atomicra1n/mechanical-wall-clock/images/clock-back.png

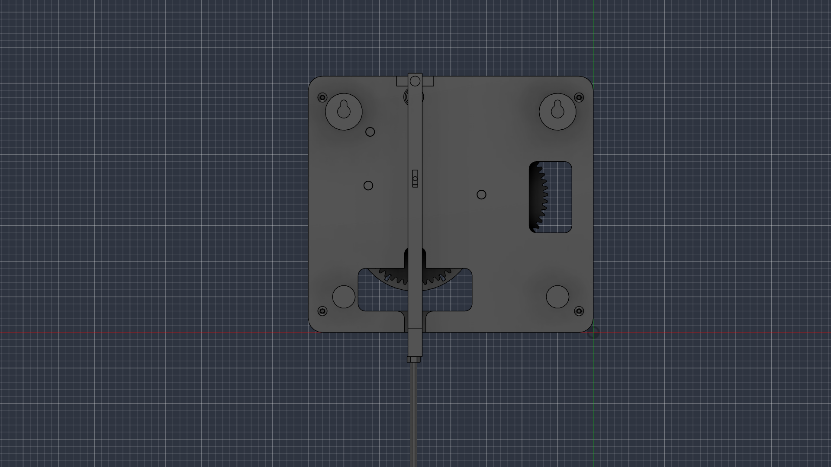
images/clock-back.png
