atomicra1n/mechanical-wall-clock/images/clock-full.png

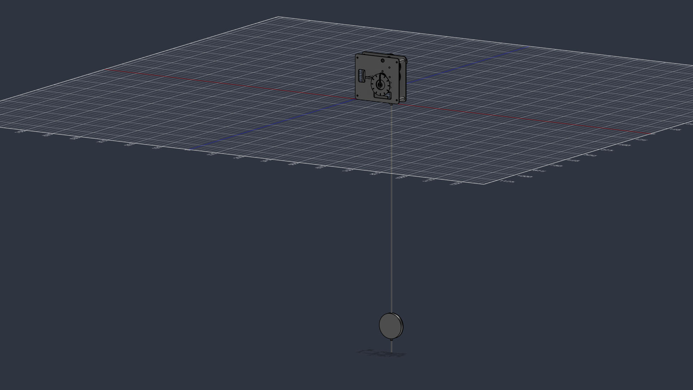
images/clock-full.png
