atomicra1n/mechanical-wall-clock/images/clock-side.png

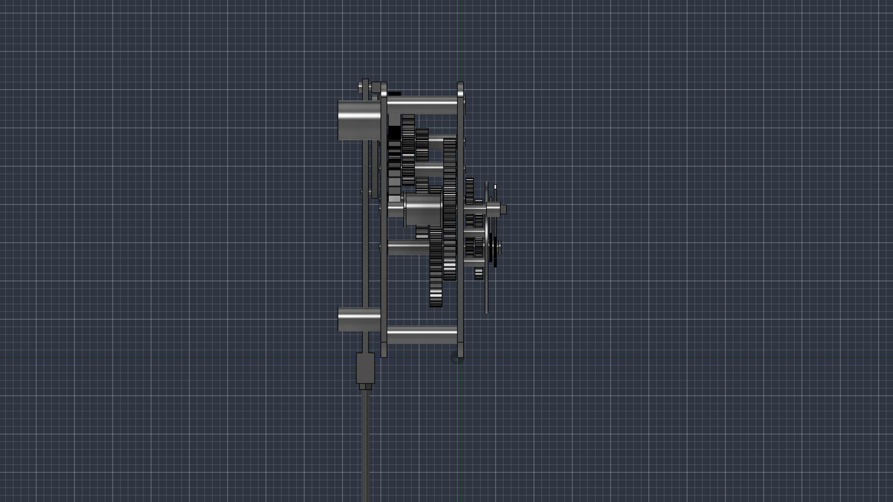
images/clock-side.png
