atomicra1n/mechanical-wall-clock/BOM.csv

Item | Qty | Supplier | Cost/item | Total Cost | link
Alu round rod 6 mm × 1 m | 1 | Hornbach | $2.50 | $2.50 | https://www.hornbach.cz/p/alu-kruhovy-profil-6mm-1m/6369446/
Zn threaded rod M5 1 m | 1 | Hornbach | $0.80 | $0.80 | https://www.hornbach.cz/p/tyc-zavitova-1m-m5-pevnost-4-8-zinek-bily-1ks/4279646/
100 pack of DIN 7985 cross-head M4x12 pan-head screws | 1 | Hornbach | $3.93 | $3.93 | https://www.hornbach.cz/p/sroub-s-cockovitou-hlavou-4-8-a-krizovou-drazkou-din-7985-m4x12-mm-galvanicky-pozinkovany-1-ks/3831265/
20 pack of M5 hex nuts, stainless A2 | 1 | Hornbach | $1.56 | $1.56 | https://www.hornbach.cz/p/matice-presna-m5-sestihranna-nerez-a2-20ks/8718281/
Bison Super Glue Gel 2 grams | 1 | Hornbach | $2.08 | $2.08 | https://www.hornbach.cz/p/vterinove-lepidlo-bison-super-glue-gel-2-g/6065686/
Polyester line 1 mm, 50 m | 1 | Hornbach | $3.40 | $3.40 | https://www.hornbach.cz/p/zednicky-provazek-haromac-delka-50m-cerveny/910338/
Elegoo PLA grey, 1.75 mm, 1 kg | 1 | Sunnysoft | $12.00 | $12.00 | https://www.sunnysoft.cz/z/400PEO-060/elegoo-pla-1-75-1kg-seda.html
Estimated total shipping | 1 |  |  | $3.00
