atomicra1n/mechanical-wall-clock/cad/mechanical-wall-clock.step

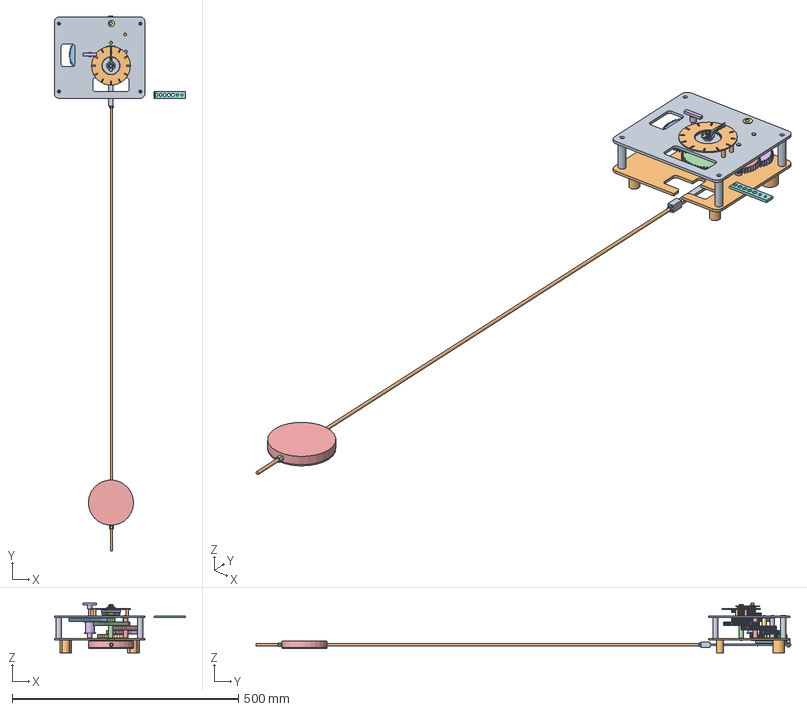
[picture p6: CAD file, 2026-11-11]
cad/mechanical-wall-clock.step
290.0 x 1183.0 x 110.0 mm
