atomicra1n/mechanical-wall-clock/stl/hour-hand.stl

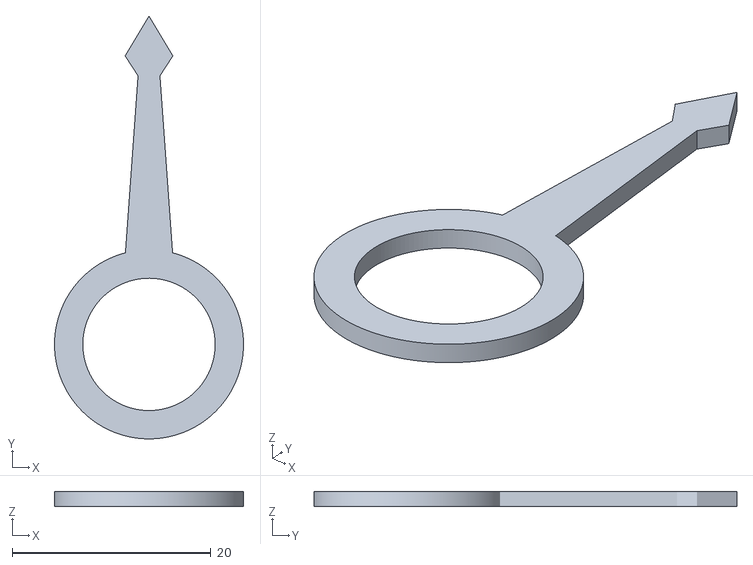
[picture p7: CAD file, 2026-11-11]
stl/hour-hand.stl
19.0 x 42.5 x 1.50
