atomicra1n/mechanical-wall-clock/stl/minute-wheel.stl

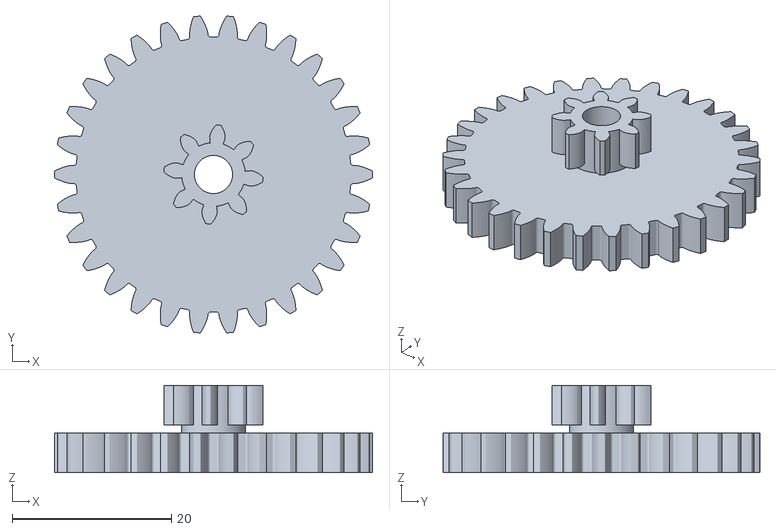
[picture p8: CAD file, 2026-11-11]
stl/minute-wheel.stl
40.0 x 39.9 x 11.0
