atomicra1n/mechanical-wall-clock/stl/hand-collet.stl

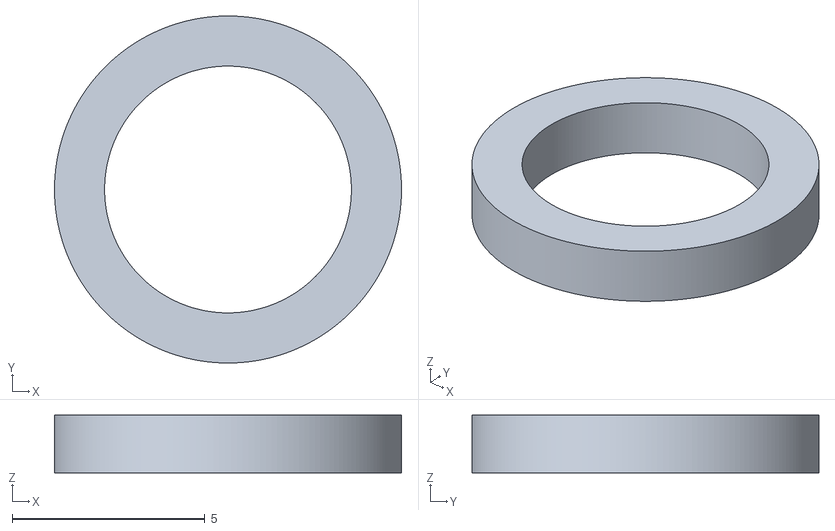
[picture p9: CAD file, 2026-11-11]
stl/hand-collet.stl
9.00 x 9.00 x 1.50
