atomicra1n/mechanical-wall-clock/stl/pendulum-top.stl

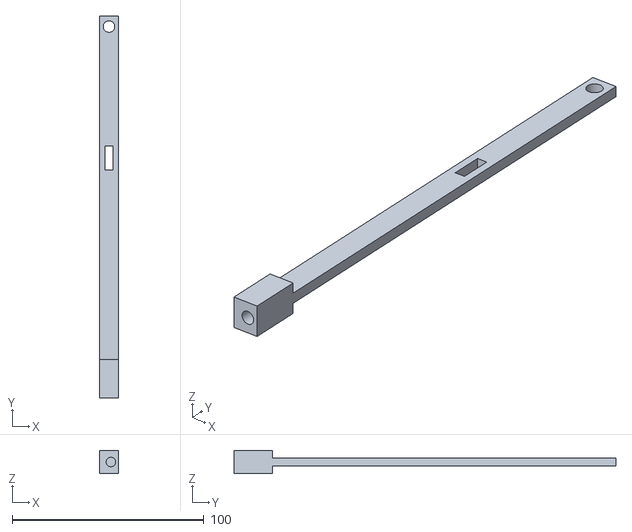
[picture p10: CAD file, 2026-11-11]
stl/pendulum-top.stl
10.0 x 199.0 x 12.0
