atomicra1n/mechanical-wall-clock/stl/hour-wheel.stl

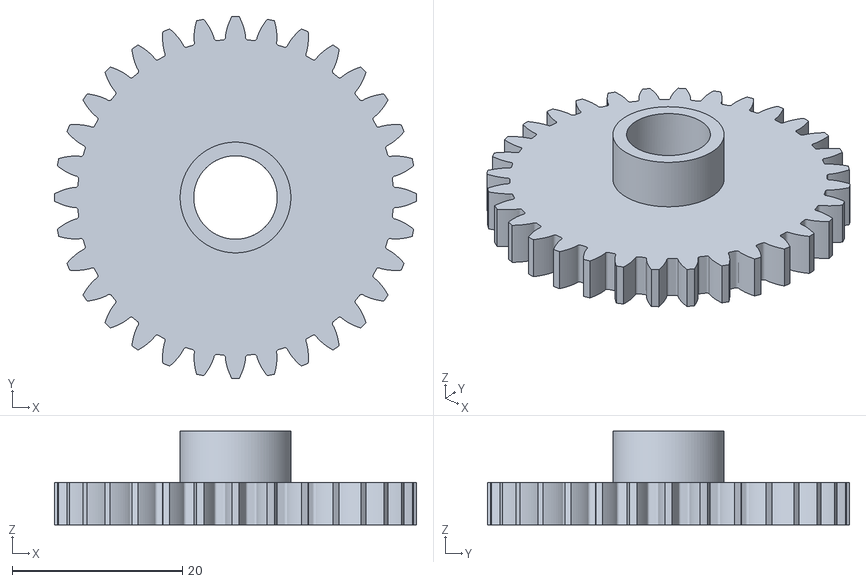
[picture p11: CAD file, 2026-11-11]
stl/hour-wheel.stl
42.5 x 42.5 x 11.0
