atomicra1n/mechanical-wall-clock/stl/dial.stl

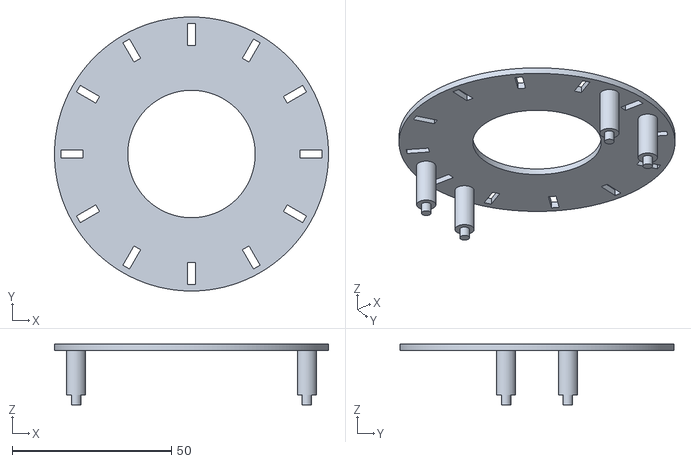
[picture p12: CAD file, 2026-11-11]
stl/dial.stl
86.0 x 86.0 x 19.0
