atomicra1n/mechanical-wall-clock/stl/cannon-pinion.stl

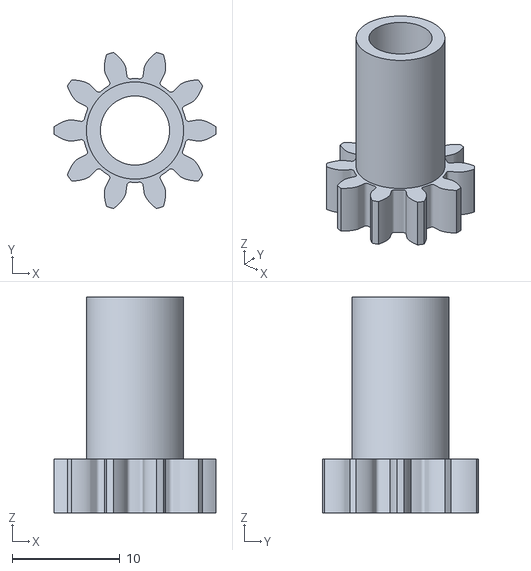
[picture p13: CAD file, 2026-11-11]
stl/cannon-pinion.stl
15.0 x 14.5 x 20.0
