atomicra1n/mechanical-wall-clock/stl/minute-hand.stl

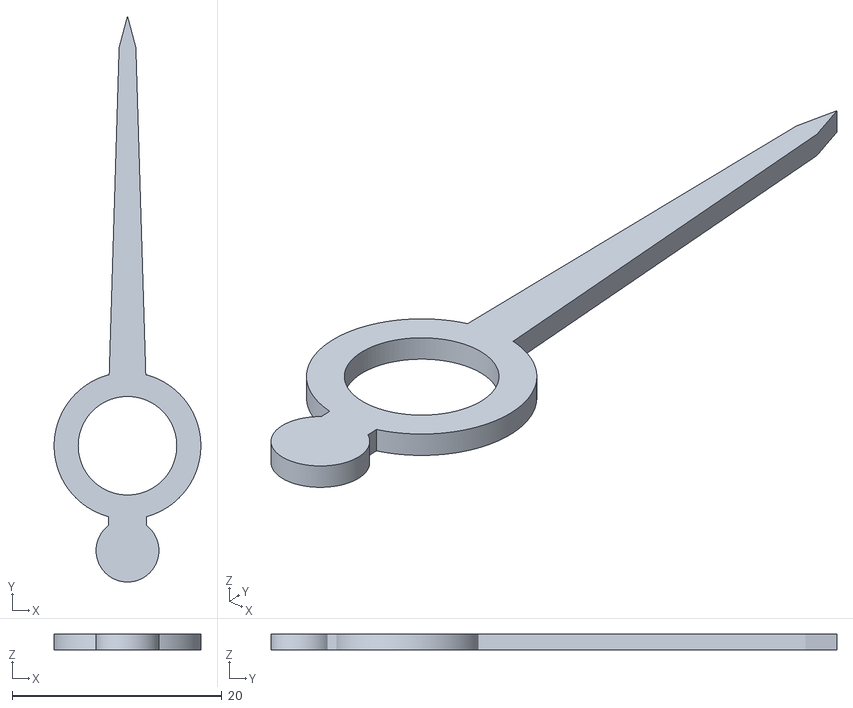
[picture p14: CAD file, 2026-11-11]
stl/minute-hand.stl
14.0 x 54.0 x 1.50
