atomicra1n/mechanical-wall-clock/stl/crutch.stl

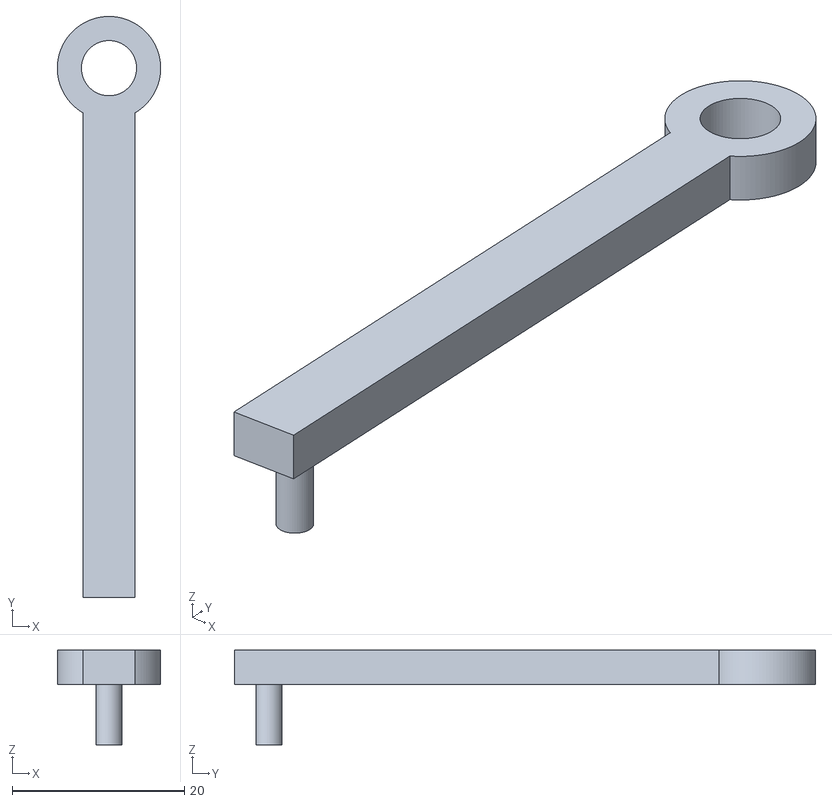
[picture p15: CAD file, 2026-11-11]
stl/crutch.stl
12.0 x 67.4 x 11.0
