atomicra1n/mechanical-wall-clock/stl/winding-drum.stl

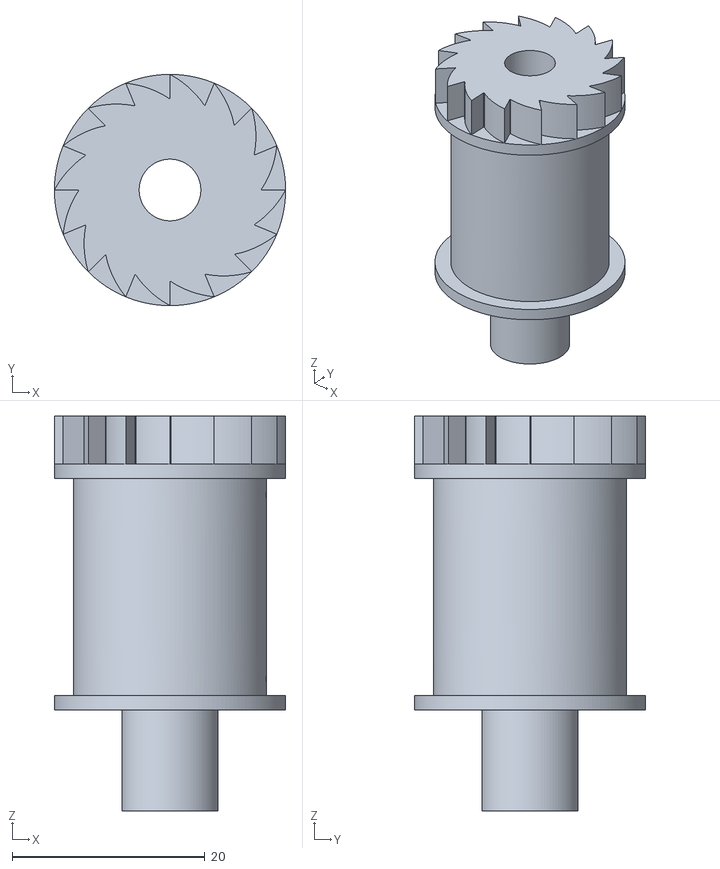
[picture p16: CAD file, 2026-11-10]
stl/winding-drum.stl
24.0 x 24.0 x 41.0
