atomicra1n/mechanical-wall-clock/stl/great-wheel.stl

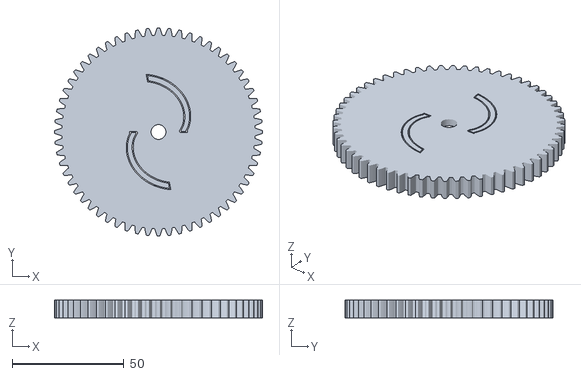
[picture p17: CAD file, 2026-11-10]
stl/great-wheel.stl
93.0 x 93.0 x 8.00
