atomicra1n/mechanical-wall-clock/stl/winding-knob.stl

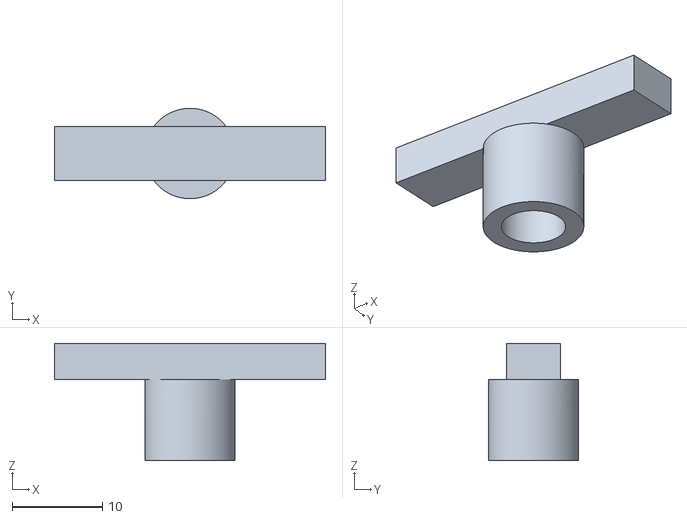
[picture p18: CAD file, 2026-11-10]
stl/winding-knob.stl
30.0 x 10.0 x 13.0
