atomicra1n/mechanical-wall-clock/stl/anchor.stl

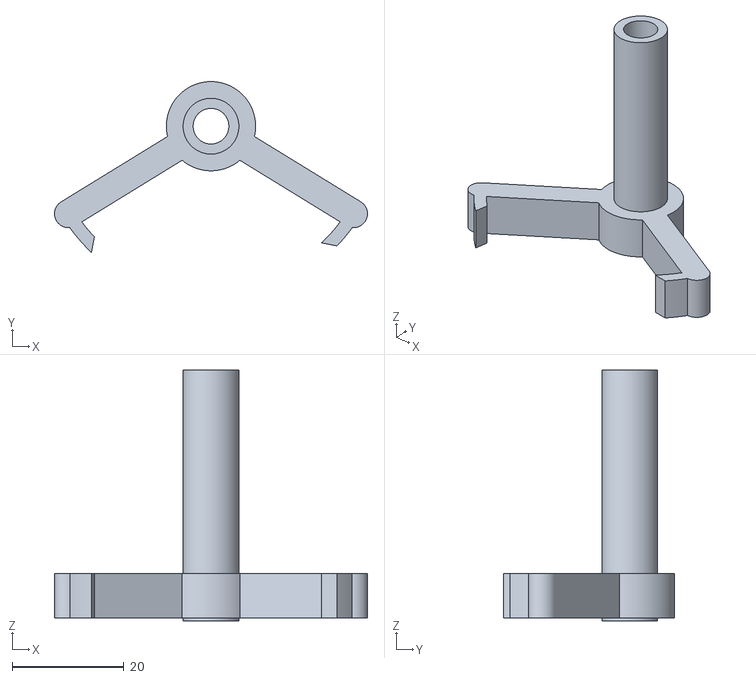
[picture p19: CAD file, 2026-11-09]
stl/anchor.stl
56.1 x 30.6 x 45.0
