atomicra1n/mechanical-wall-clock/stl/third-arbor.stl

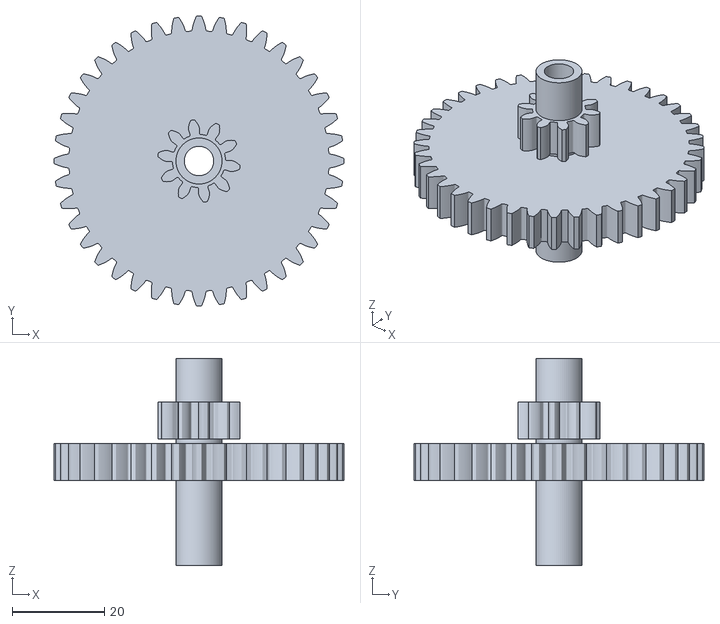
[picture p20: CAD file, 2026-11-09]
stl/third-arbor.stl
63.0 x 63.0 x 45.0
