atomicra1n/mechanical-wall-clock/stl/escape-arbor.stl

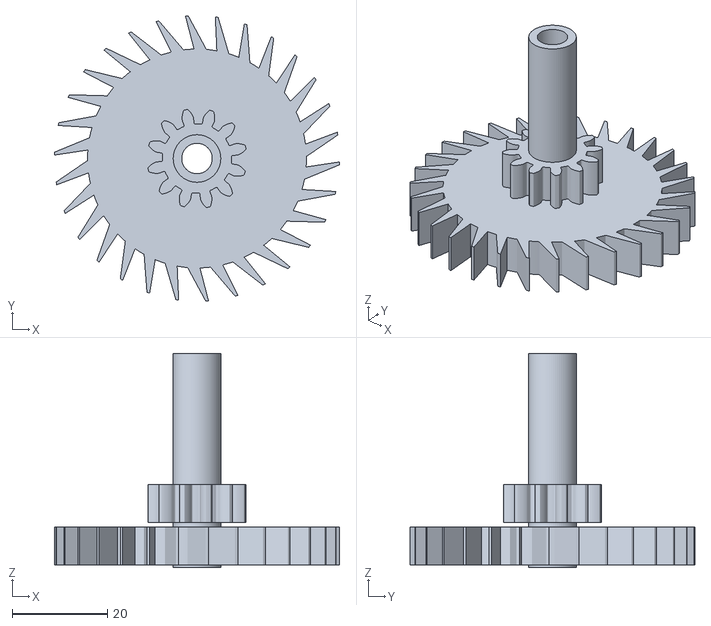
[picture p21: CAD file, 2026-11-09]
stl/escape-arbor.stl
60.0 x 59.9 x 45.0
