atomicra1n/mechanical-wall-clock/stl/center-arbor.stl

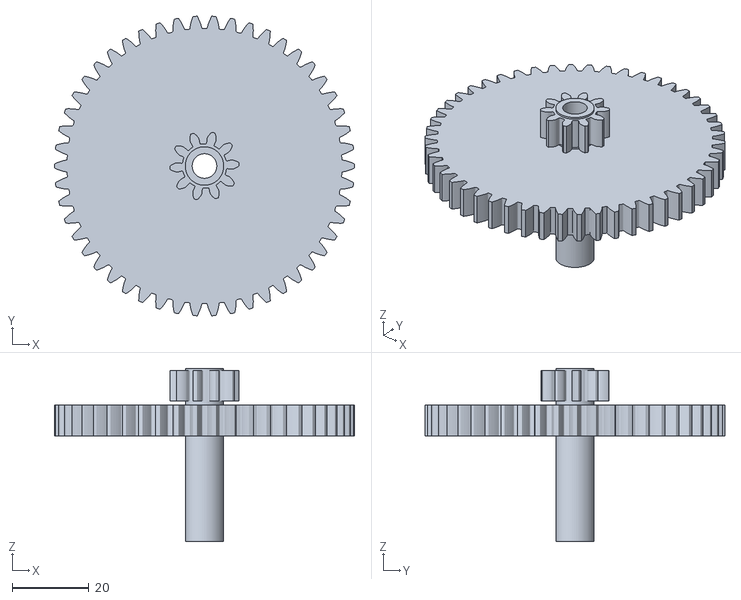
[picture p22: CAD file, 2026-11-09]
stl/center-arbor.stl
78.0 x 77.9 x 45.0
