atomicra1n/mechanical-wall-clock/stl/pendulum-bob.stl

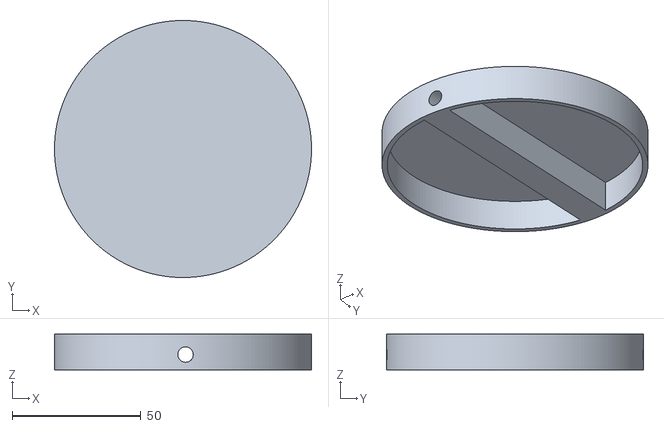
[picture p23: CAD file, 2026-11-08]
stl/pendulum-bob.stl
100.0 x 100.0 x 14.0
