atomicra1n/mechanical-wall-clock/stl/bob-lid.stl

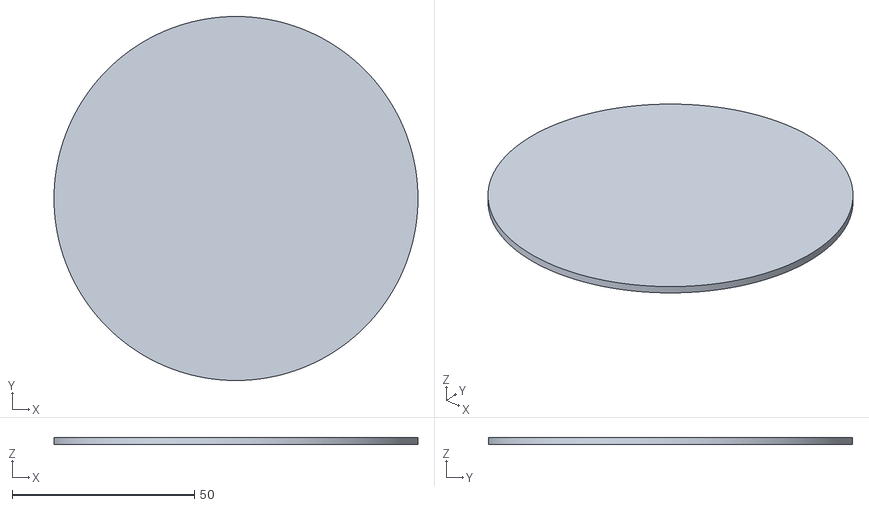
[picture p24: CAD file, 2026-11-08]
stl/bob-lid.stl
100.0 x 100.0 x 2.00
