atomicra1n/mechanical-wall-clock/stl/fourth-arbor.stl

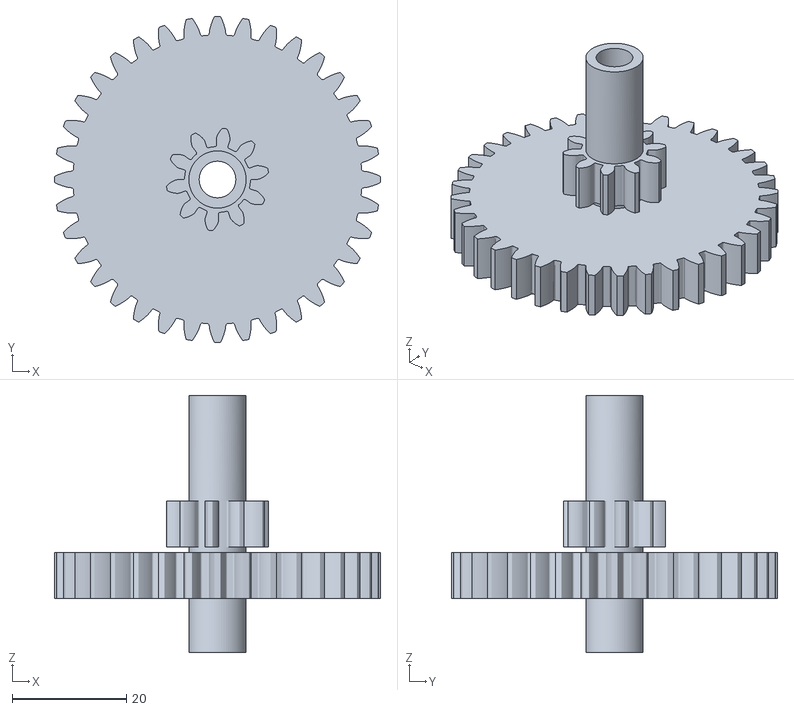
[picture p25: CAD file, 2026-11-08]
stl/fourth-arbor.stl
57.0 x 57.0 x 45.0
