atomicra1n/mechanical-wall-clock/stl/bushing-back.stl

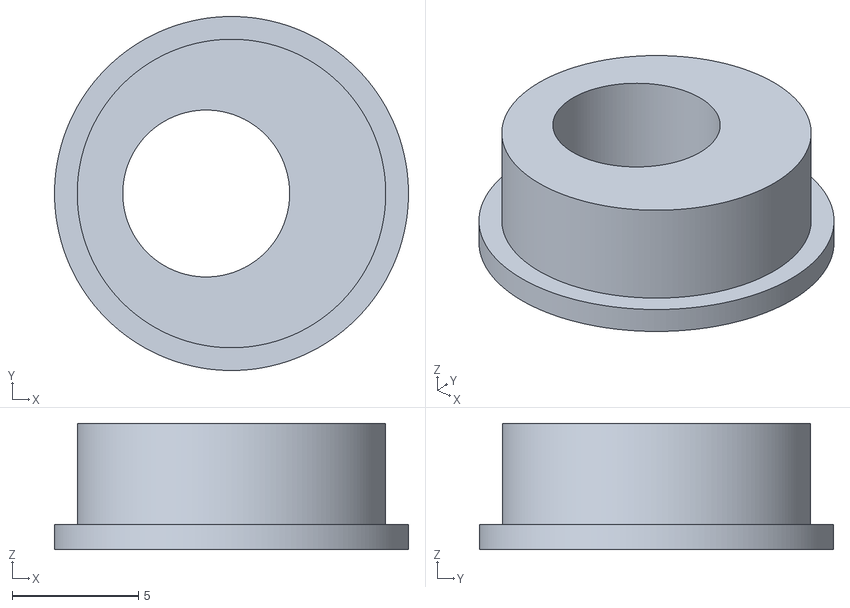
[picture p26: CAD file, 2026-11-05]
stl/bushing-back.stl
14.0 x 14.0 x 5.00
