atomicra1n/mechanical-wall-clock/stl/standoff-x4.stl

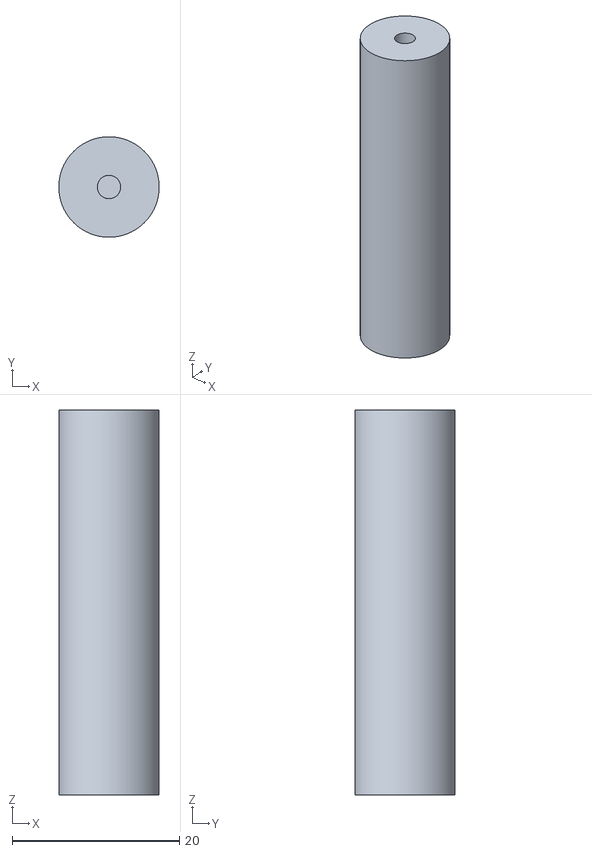
[picture p27: CAD file, 2026-11-05]
stl/standoff-x4.stl
12.0 x 12.0 x 46.0
