atomicra1n/mechanical-wall-clock/stl/front-plate.stl

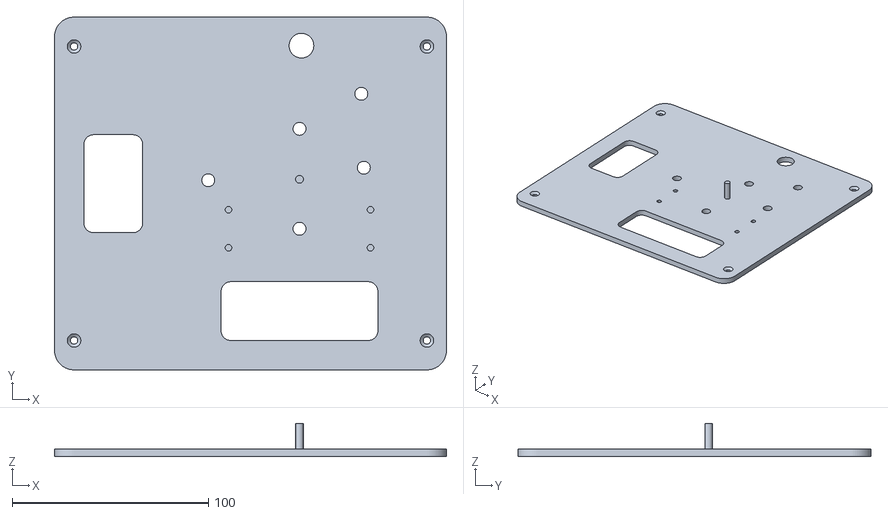
[picture p28: CAD file, 2026-11-05]
stl/front-plate.stl
200.0 x 180.0 x 17.0
