atomicra1n/mechanical-wall-clock/stl/back-plate.stl

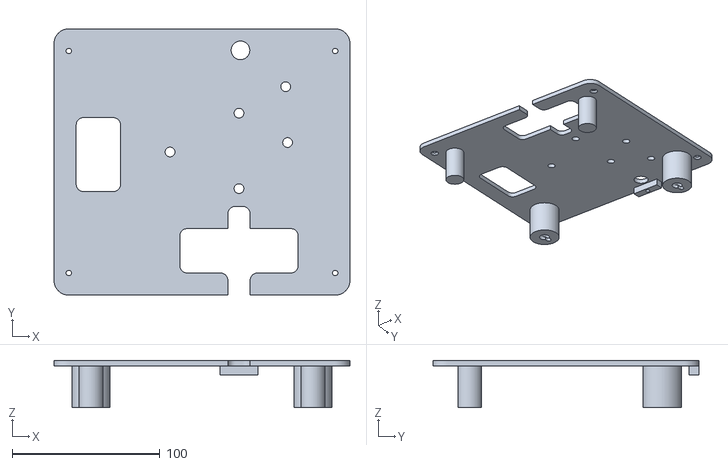
[picture p29: CAD file, 2026-11-05]
stl/back-plate.stl
200.0 x 180.0 x 32.0
