atomicra1n/mechanical-wall-clock/stl/tolerance-test.stl

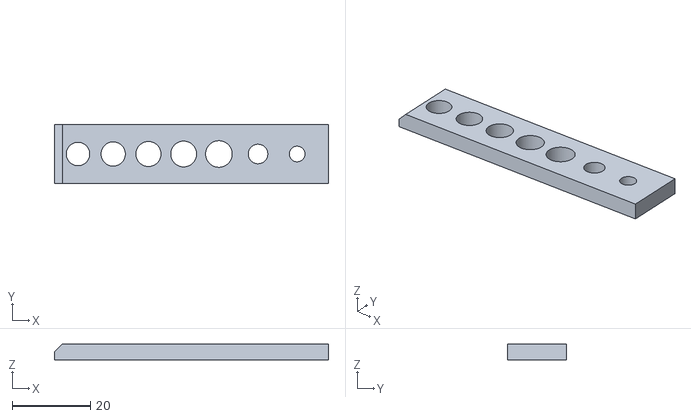
[picture p30: CAD file, 2026-10-17]
stl/tolerance-test.stl
70.0 x 15.0 x 4.00
