atomicra1n/mechanical-wall-clock/(list of files, cad)

Other CAD files:
stl/bushing-front.stl
cad/Mechanical Wall Clock.f3d
