atomicra1n/mechanical-wall-clock/(commit log)

2026-10-17 Push STL/images/step
    [anchor.stl, back-plate.stl, bob-lid.stl, bushing-back.stl, bushing-front.stl, cannon-pinion.stl, center-arbor.stl, crutch.stl]
2026-10-17 Sync Mechanical Wall Clock from Half Life
    [BOM.csv]
2026-10-24 Create Mechanical Wall Clock.f3d
    [Mechanical Wall Clock.f3d]
2026-11-05 tolerance changes after test print strip
    [Mechanical Wall Clock.f3d, back-plate.stl, bushing-back.stl, bushing-front.stl, front-plate.stl, mechanical-wall-clock.step, standoff-x4.stl]
2026-11-08 change sizing for tolerance adjustments
    [Mechanical Wall Clock.f3d, bob-lid.stl, fourth-arbor.stl, mechanical-wall-clock.step, pendulum-bob.stl]
2026-11-09 Edit filament in BOM
    [BOM.csv]
2026-11-09 tolerance fixes
    [Mechanical Wall Clock.f3d, anchor.stl, center-arbor.stl, escape-arbor.stl, mechanical-wall-clock.step, third-arbor.stl]
2026-11-10 Tolerance and BOM changes
    [BOM.csv, Mechanical Wall Clock.f3d, great-wheel.stl, mechanical-wall-clock.step, winding-drum.stl, winding-knob.stl]
2026-11-11 tolerance adjustments
    [Mechanical Wall Clock.f3d, cannon-pinion.stl, crutch.stl, dial.stl, hand-collet.stl, hour-hand.stl, hour-wheel.stl, mechanical-wall-clock.step]
